Kirill-Zaikin/MY_WORK_REPOSITORY/Robot_forklift/Наклейки/РОБОТЫ НА ОДНОЛ ЛИСТЕ.pdf

РОБОТ 9 МФТИ | РОБОТ 2
РОБОТ 2 МФТИ | РОБОТ 3 МФТИ
РОБОТ 7 МФТИ | РОБОТ 8 МФТИ
