Kirill-Zaikin/MY_WORK_REPOSITORY/Robot_forklift/КД/PDF/чертежи Николки/Перечень чертежей.pdf

ЛТПУ.001.000.000.00

Изм. | Кол.уч | Лист | №док
Подпись | Дата
Разраб. | Герштейн
Програмно-аппаратный комплекс (ПАК)
Стадия | Лист | Листов
1 | 3

ООО «Беспилотный
погрузчик»

Взам. инв. №

Подп. и дата Инв. № подл.

Перечень чертежей

Лист | Наименование | ЦИФР
1 | Габаритный чертеж | ЛТПУ.001.000.000.00 ГЧ
2 | Схема деления | ЛТПУ.001.000.000.00 СД
3 | Принципиальная схема ПАК Э3 | ЛТПУ.001.000.000.00 Э3
4 | Перечень элементов ПАК
5 | Принципиальная схема платы управления Э3 | ЛТПУ.001.001.001.01 Э3
6 | Перечень элементов платы управления
7 | ПАК схема соединения | ЛТПУ.001.000.000.00 СС
8 | ПАК СБ | ЛТПУ.001.000.000.00 СБ
9 | Оптико-электронный комплекс СБ | ЛТПУ.001.001.000.00 СБ
10 | Пояс Безопасности СБ | ЛТПУ.001.002.000.00 СБ
11 | Курсовая камера СБ | ЛТПУ.001.003.000.00 СБ
12 | Концевой выключатель СБ | ЛТПУ.001.004.000.00 СБ
13 | Блок Управления СБ | ЛТПУ.001.001.001.00 СБ
14 | Боковая камера правая СБ | ЛТПУ.001.001.002.00 СБ
15 | Боковая камера левая СБ | ЛТПУ.001.001.003.00 СБ
16 | Защита лидара правая СБ | ЛТПУ.001.002.001.00 СБ
17 | Защита лидара левая СБ | ЛТПУ.001.002.002.00 СБ
18 | Боковая стенка | ЛТПУ.001.001.001.01

ЛТПУ.001.000.000.00

Лист
2
Изм. | Кол.
Лист | №док. | Подп. | Дата

Взам. инв. № Подп. и дата Инв. № подл.

19 | Боковая стенка с отверстиями под кнопки | ЛТПУ.001.001.001.02
20 | Торцевая стенка | ЛТПУ.001.001.001.03
21 | Верхняя стенка | ЛТПУ.001.001.001.04
22 | Нижняя часть коробки для jetson | ЛТПУ.001.001.001.05
23 | Верхняя часть коробки для jetson | ЛТПУ.001.001.001.06
24 | Подложка jetson | ЛТПУ.001.001.001.07
25 | Подложка платы | ЛТПУ.001.001.001.08
26 | Переходная пластина бесперебойника | ЛТПУ.001.001.001.09
27 | Нижняя часть крепления навигационной камеры | ЛТПУ.001.001.001.10
28 | Верхняя часть крепления навигационной камеры | ЛТПУ.001.001.001.11
29 | Держатель разъема | ЛТПУ.001.001.001.12
30 | Боковина крепления камеры | ЛТПУ.001.001.002.01
31 | Боковина крепления камеры 30 градусов | ЛТПУ.001.001.002.02
32 | Пластина камеры под 30 градусов | ЛТПУ.001.001.002.03
33 | Основа крепления камеры | ЛТПУ.001.001.002.04
34 | Переходная пластина камеры правая | ЛТПУ.001.001.002.05
35 | Переходная пластина камеры левая | ЛТПУ.001.001.003.01
36 | Г-образная опора ОЭК | ЛТПУ.001.001.000.01
37 | Задняя опора ОЭК | ЛТПУ.001.001.000.02
38 | Профиль боковой правый | ЛТПУ.001.002.000.01
39 | Профиль боковой левый | ЛТПУ.001.002.000.02
40 | Профиль фронта | ЛТПУ.001.002.000.03
41 | Профиль для пояса безопасности | ЛТПУ.001.002.000.04
42 | Основа лидара нижняя часть | ЛТПУ.001.002.001.01
43 | Основа лидара верхняя часть | ЛТПУ.001.002.001.02

ЛТПУ.001.000.000.00

Лист
3
Изм. | Кол.
Лист | №док. | Подп. | Дата

Взам. инв. № Подп. и дата Инв. № подл.

44 | Боковина лидара | ЛТПУ.001.002.001.03
45 | Крепление курсовой камеры | ЛТПУ.001.003.000.01
46 | Подставка крепления курсовой камеры | ЛТПУ.001.003.000.02
47 | Корпус концевого выключателя | ЛТПУ.001.004.000.01
48 | Толкатель концевого выключателя | ЛТПУ.001.004.000.02
