Kirill-Zaikin/MY_WORK_REPOSITORY/Robot_forklift/КД/PDF/чертежи Николки/temp_A1.png

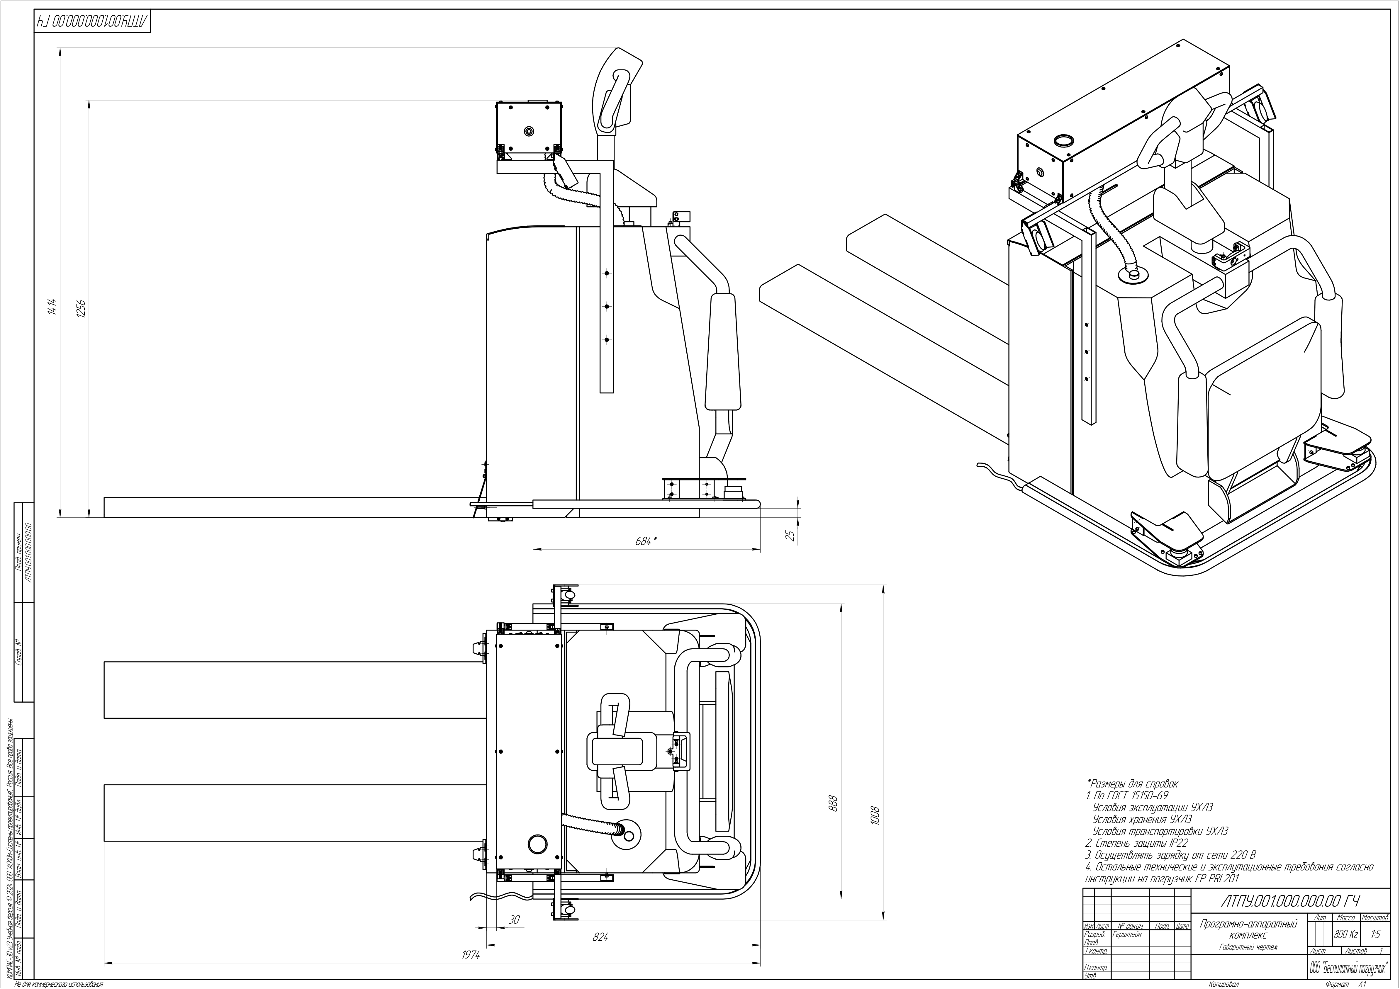
Robot_forklift/КД/PDF/чертежи Николки/temp_A1.png
