Kirill-Zaikin/MY_WORK_REPOSITORY/Robot_forklift/КД/PDF/чертежи Николки/temp_W1686_H2396.png

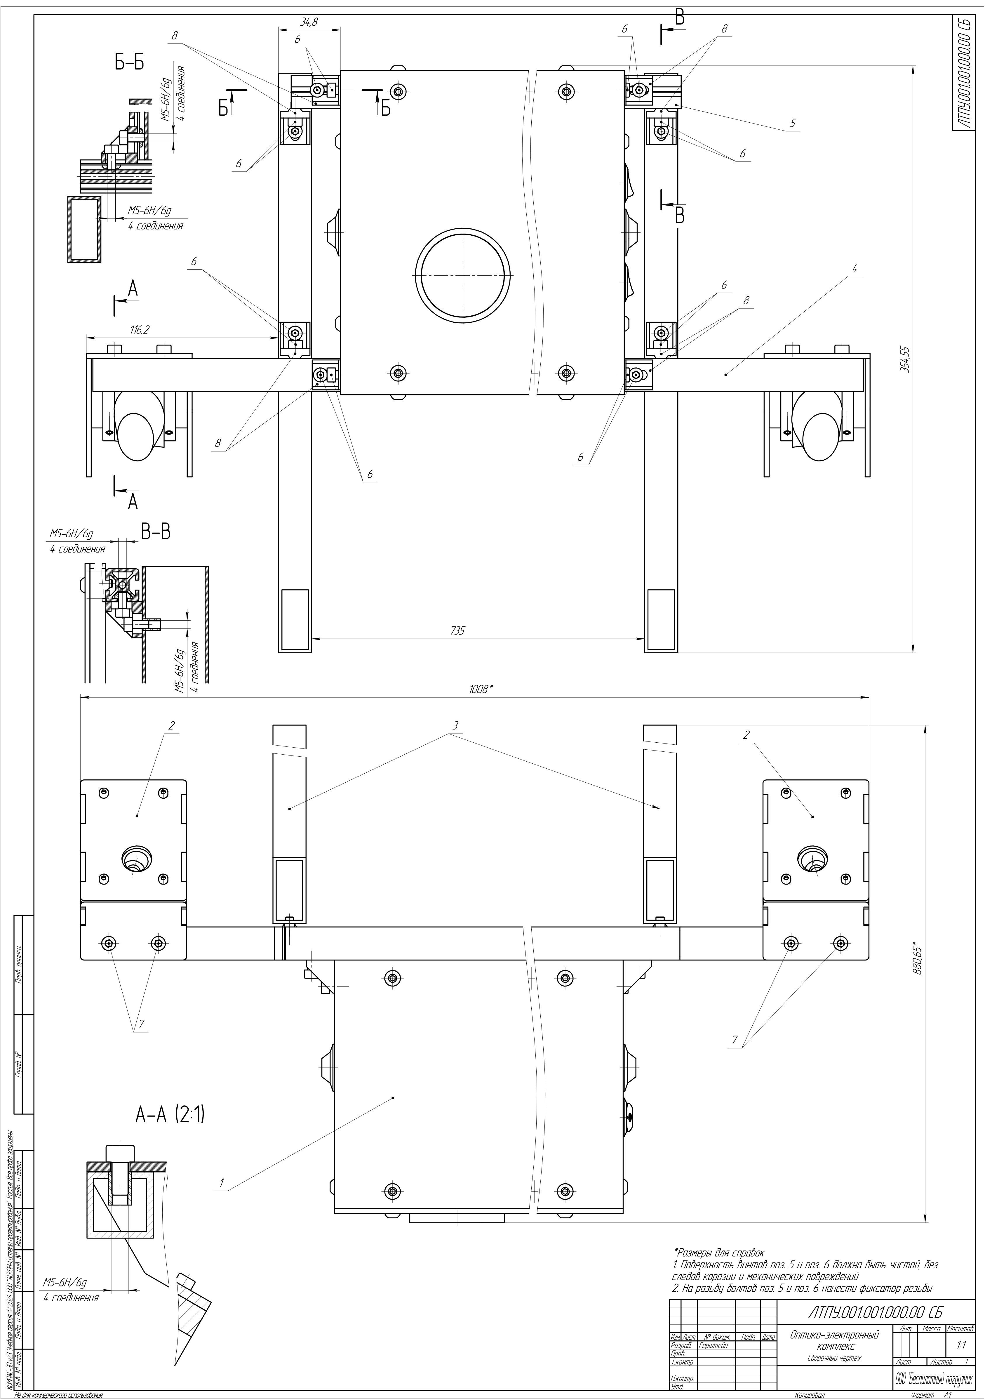
Robot_forklift/КД/PDF/чертежи Николки/temp_W1686_H2396.png
