Kirill-Zaikin/MY_WORK_REPOSITORY/Robot_forklift/КД/Печатные платы/Ублюдок/ChineGerber/Main_STM_box-F_Cu.dxf

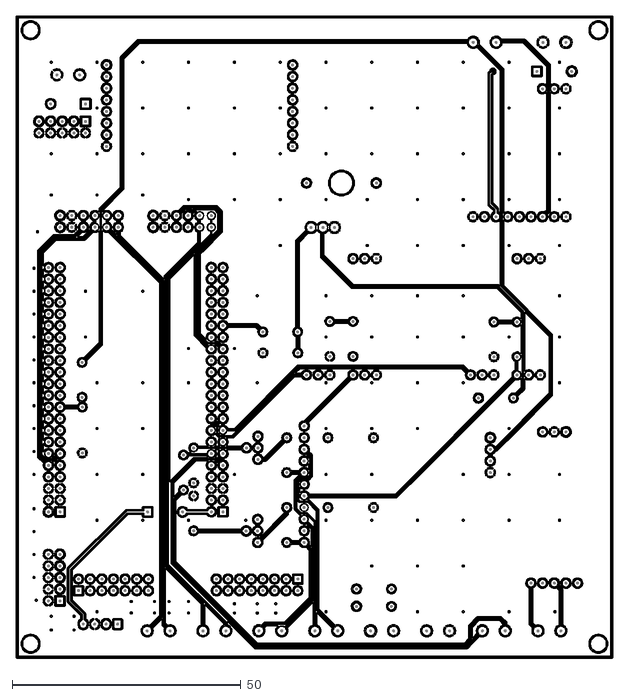
[picture p15: CAD file, 2025-08-18]
Robot_forklift/КД/Печатные платы/Ублюдок/ChineGerber/Main_STM_box-F_Cu.dxf
130.2 x 140.2
