Kirill-Zaikin/MY_WORK_REPOSITORY/Robot_forklift/модели/Колику/разъем_2022.SLDASM

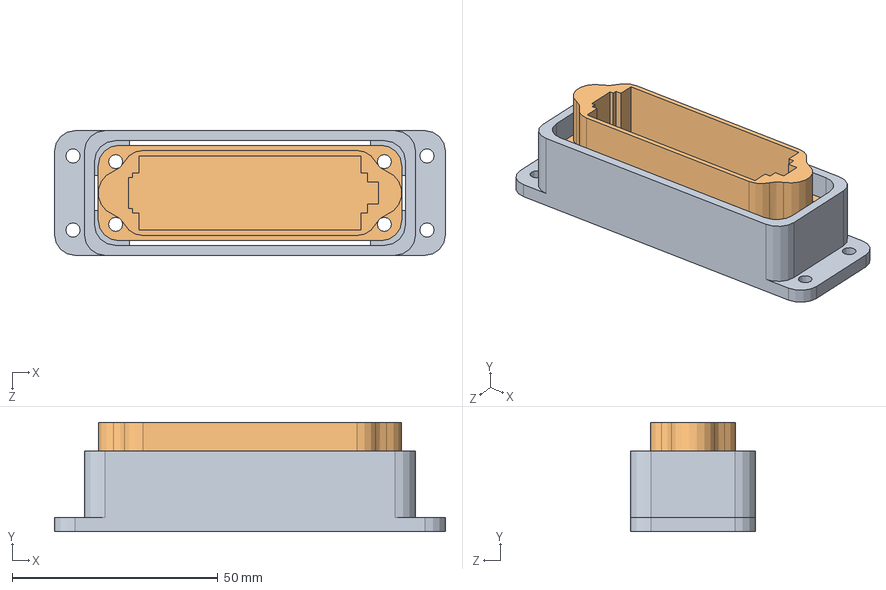
[picture p16: CAD file, 2025-08-18]
Robot_forklift/модели/Колику/разъем_2022.SLDASM
95.0 x 26.6 x 30.3 mm
разъем 20 контактов_рубашка
Вилка 20 контактов
