Kirill-Zaikin/MY_WORK_REPOSITORY/Robot_forklift/модели/Петля/Петля.SLDASM

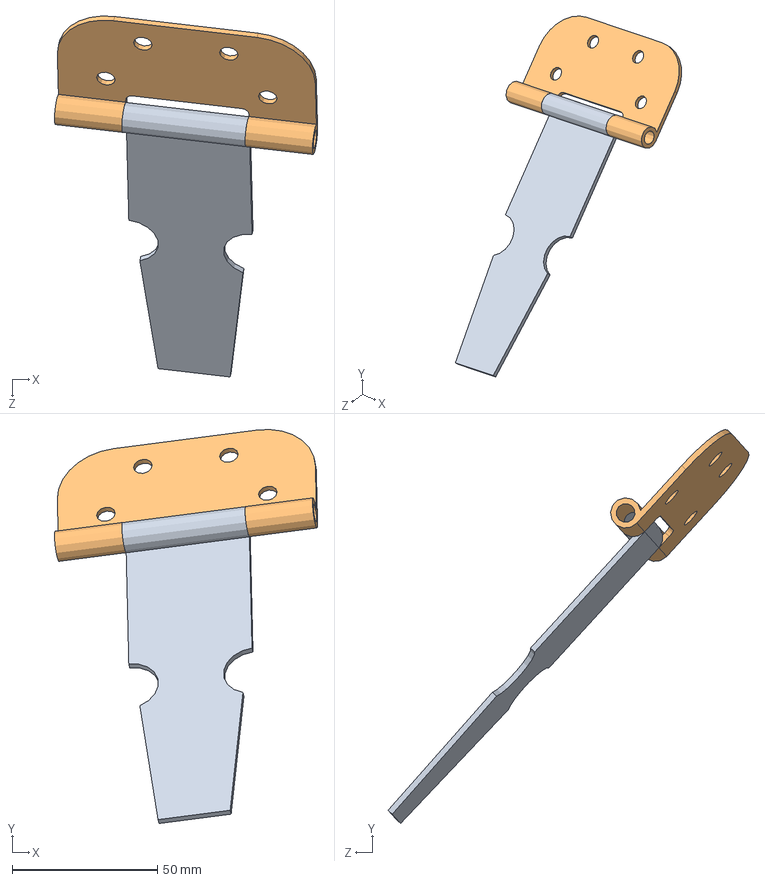
[picture p17: CAD file, 2025-08-18]
Robot_forklift/модели/Петля/Петля.SLDASM
90.4 x 135.4 x 124.1 mm
Тело петли
Язычок петли
