Kirill-Zaikin/MY_WORK_REPOSITORY/Robot_forklift/модели/Колику/Петля_2022.SLDASM

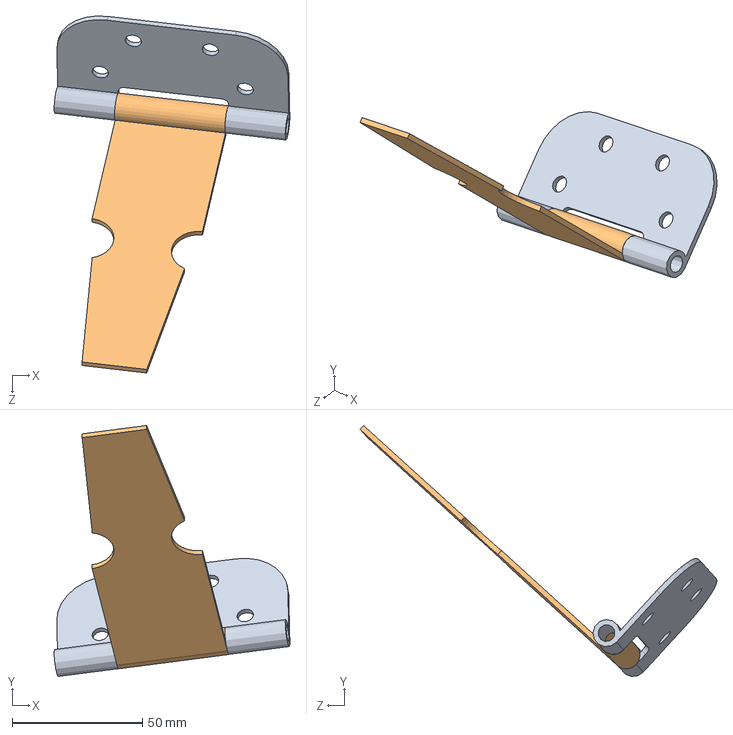
[picture p20: CAD file, 2025-08-18]
Robot_forklift/модели/Колику/Петля_2022.SLDASM
90.4 x 96.3 x 137.0 mm
Тело петли
Язычок петли
