Kirill-Zaikin/MY_WORK_REPOSITORY/Robot_forklift/модели/Оптический фильтр.SLDPRT

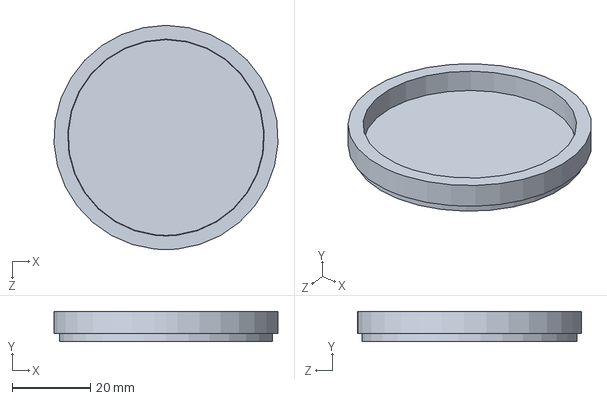
[picture p21: CAD file, 2025-08-18]
Robot_forklift/модели/Оптический фильтр.SLDPRT
57.2 x 7.69 x 57.3 mm
