Kirill-Zaikin/MY_WORK_REPOSITORY/Robot_forklift/модели/разъем/разъем 20 контактов_рубашка.SLDPRT

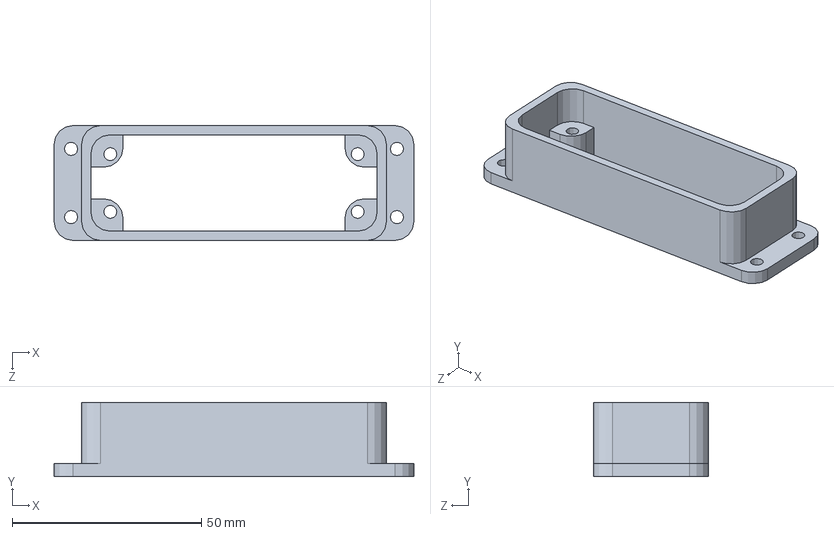
[picture p22: CAD file, 2025-08-18]
Robot_forklift/модели/разъем/разъем 20 контактов_рубашка.SLDPRT
95.0 x 19.5 x 30.3 mm
