Kirill-Zaikin/MY_WORK_REPOSITORY/Robot_forklift/Оснастка/Винт для лампы.SLDPRT

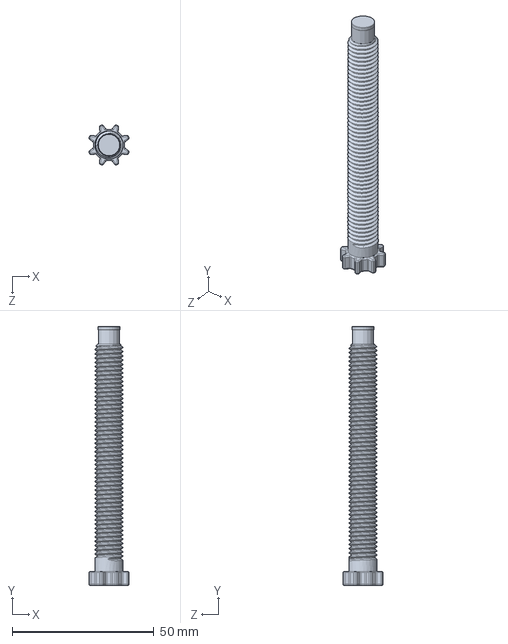
[picture p23: CAD file, 2025-03-12]
Robot_forklift/Оснастка/Винт для лампы.SLDPRT
14.1 x 91.2 x 14.1 mm
