Kirill-Zaikin/MY_WORK_REPOSITORY/Robot_forklift/модели/Выключатель клавишный круглый.SLDPRT

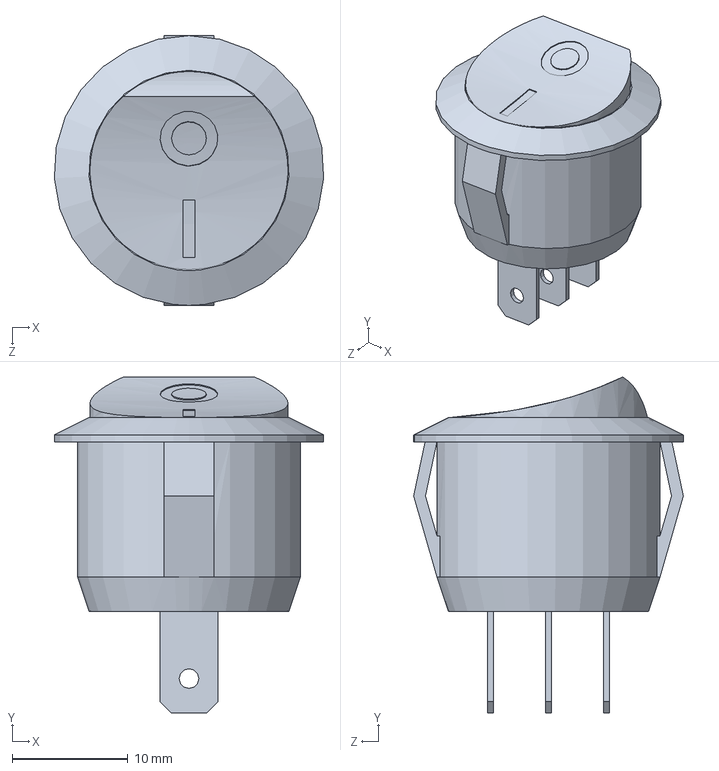
[picture p24: CAD file, 2025-08-18]
Robot_forklift/модели/Выключатель клавишный круглый.SLDPRT
23.3 x 29.0 x 23.3 mm
