Kirill-Zaikin/MY_WORK_REPOSITORY/Robot_forklift/модели/Колику/Тело петли_2022.SLDPRT

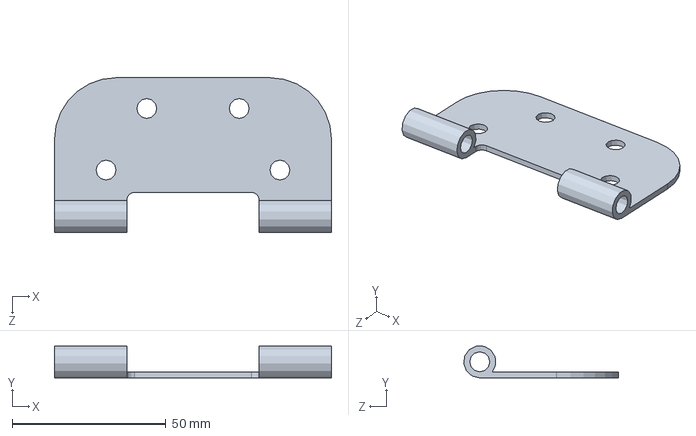
[picture p25: CAD file, 2025-08-18]
Robot_forklift/модели/Колику/Тело петли_2022.SLDPRT
90.0 x 10.4 x 50.2 mm
