Kirill-Zaikin/MY_WORK_REPOSITORY/Robot_forklift/модели/разъем/Вилка 20 контактов.SLDPRT

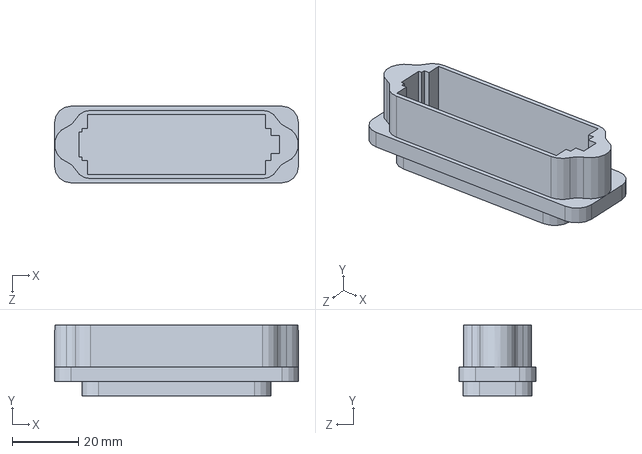
[picture p26: CAD file, 2025-08-18]
Robot_forklift/модели/разъем/Вилка 20 контактов.SLDPRT
73.8 x 21.4 x 23.2 mm
