Kirill-Zaikin/MY_WORK_REPOSITORY/Robot_forklift/Оснастка/Держало лампы.STEP

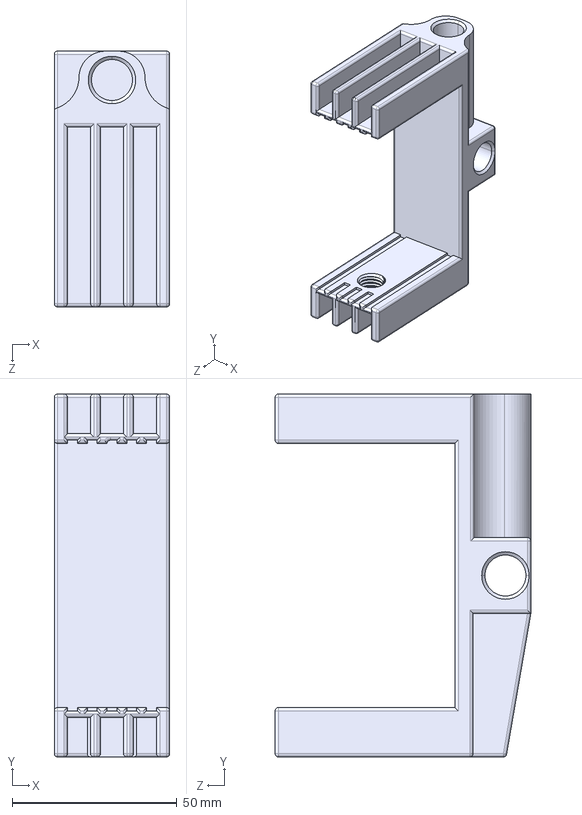
[picture p27: CAD file, 2025-03-12]
Robot_forklift/Оснастка/Держало лампы.STEP
35.0 x 110.0 x 77.5 mm
