Kirill-Zaikin/MY_WORK_REPOSITORY/Robot_forklift/модели/Кнопка пояса.SLDPRT

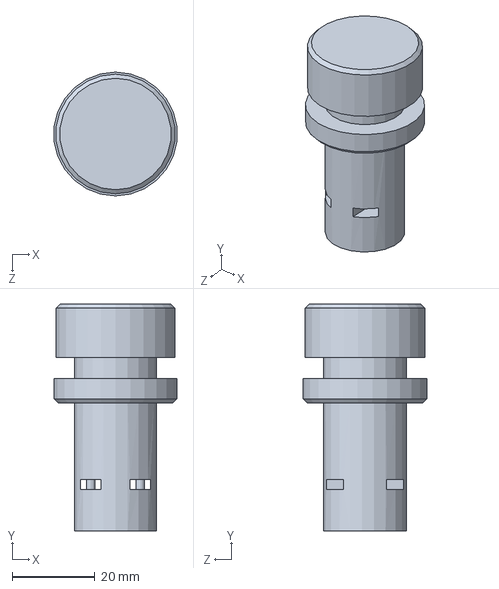
[picture p28: CAD file, 2025-08-18]
Robot_forklift/модели/Кнопка пояса.SLDPRT
29.8 x 55.0 x 30.0 mm
