Kirill-Zaikin/MY_WORK_REPOSITORY/Robot_forklift/модели/Колику/гофра_2022.SLDPRT

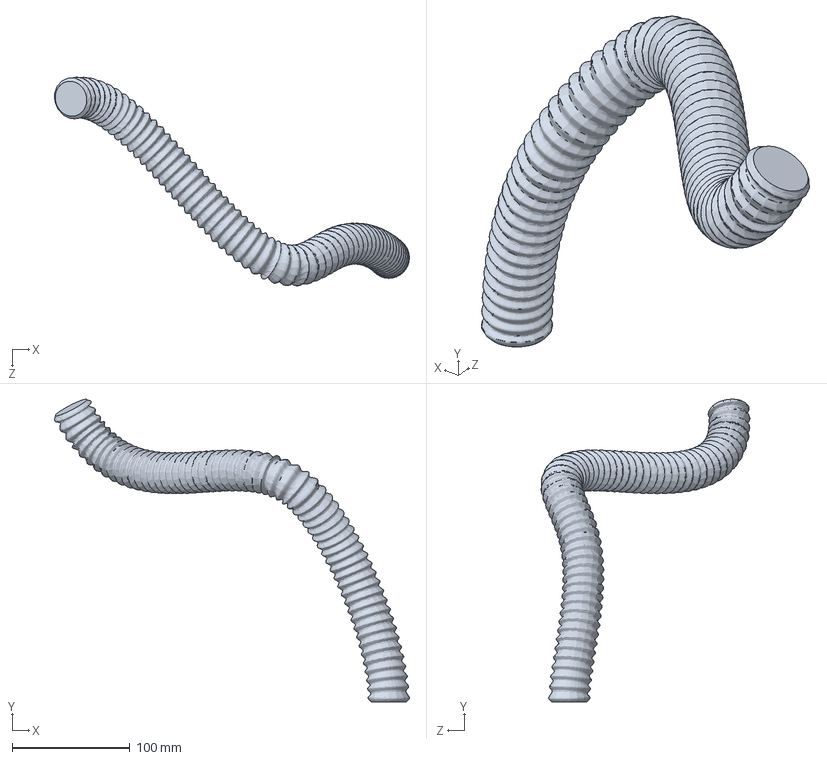
[picture p29: CAD file, 2025-08-18]
Robot_forklift/модели/Колику/гофра_2022.SLDPRT
301.6 x 257.2 x 177.3 mm
