Kirill-Zaikin/MY_WORK_REPOSITORY/Robot_forklift/модели/Петля/Язычок петли.SLDPRT

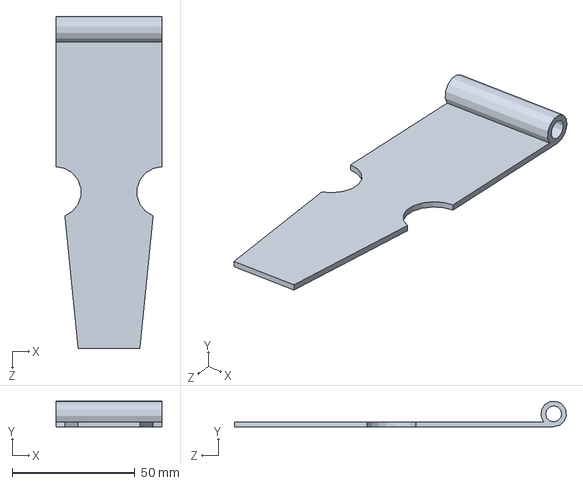
[picture p30: CAD file, 2025-08-18]
Robot_forklift/модели/Петля/Язычок петли.SLDPRT
43.0 x 10.4 x 135.2 mm
