Kirill-Zaikin/MY_WORK_REPOSITORY/Robot_forklift/модели/Поворотник.SLDPRT

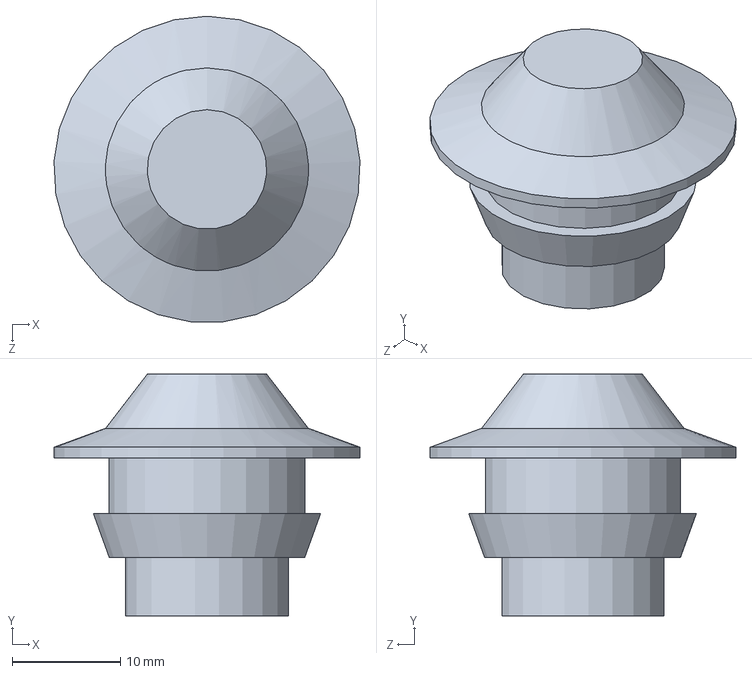
[picture p31: CAD file, 2025-08-18]
Robot_forklift/модели/Поворотник.SLDPRT
28.3 x 22.3 x 28.2 mm
