Kirill-Zaikin/MY_WORK_REPOSITORY/(list of files, cad)

Other CAD files:
Robot_forklift/модели/разъем/разъем.SLDASM
Robot_forklift/модели/Петля/Тело петли.SLDPRT
Robot_forklift/модели/Колику/Кнопка пояса_2022.SLDPRT
Robot_forklift/модели/гофра.SLDPRT
Robot_forklift/модели/Колику/Выключатель клавишный круглый_2022.SLDPRT
Robot_forklift/модели/Колику/рубашка_2022.SLDPRT
Robot_forklift/модели/Колику/Язычок петли_2022.SLDPRT
Robot_forklift/модели/Колику/Поворотник_2022.SLDPRT
Robot_forklift/модели/Колику/Вилка_2022.SLDPRT
Robot_forklift/модели/Колику/Оптический фильтр_2022.SLDPRT
