Kirill-Zaikin/MY_WORK_REPOSITORY/Robot_forklift/КД/PDF/ПАК перечень.pdf

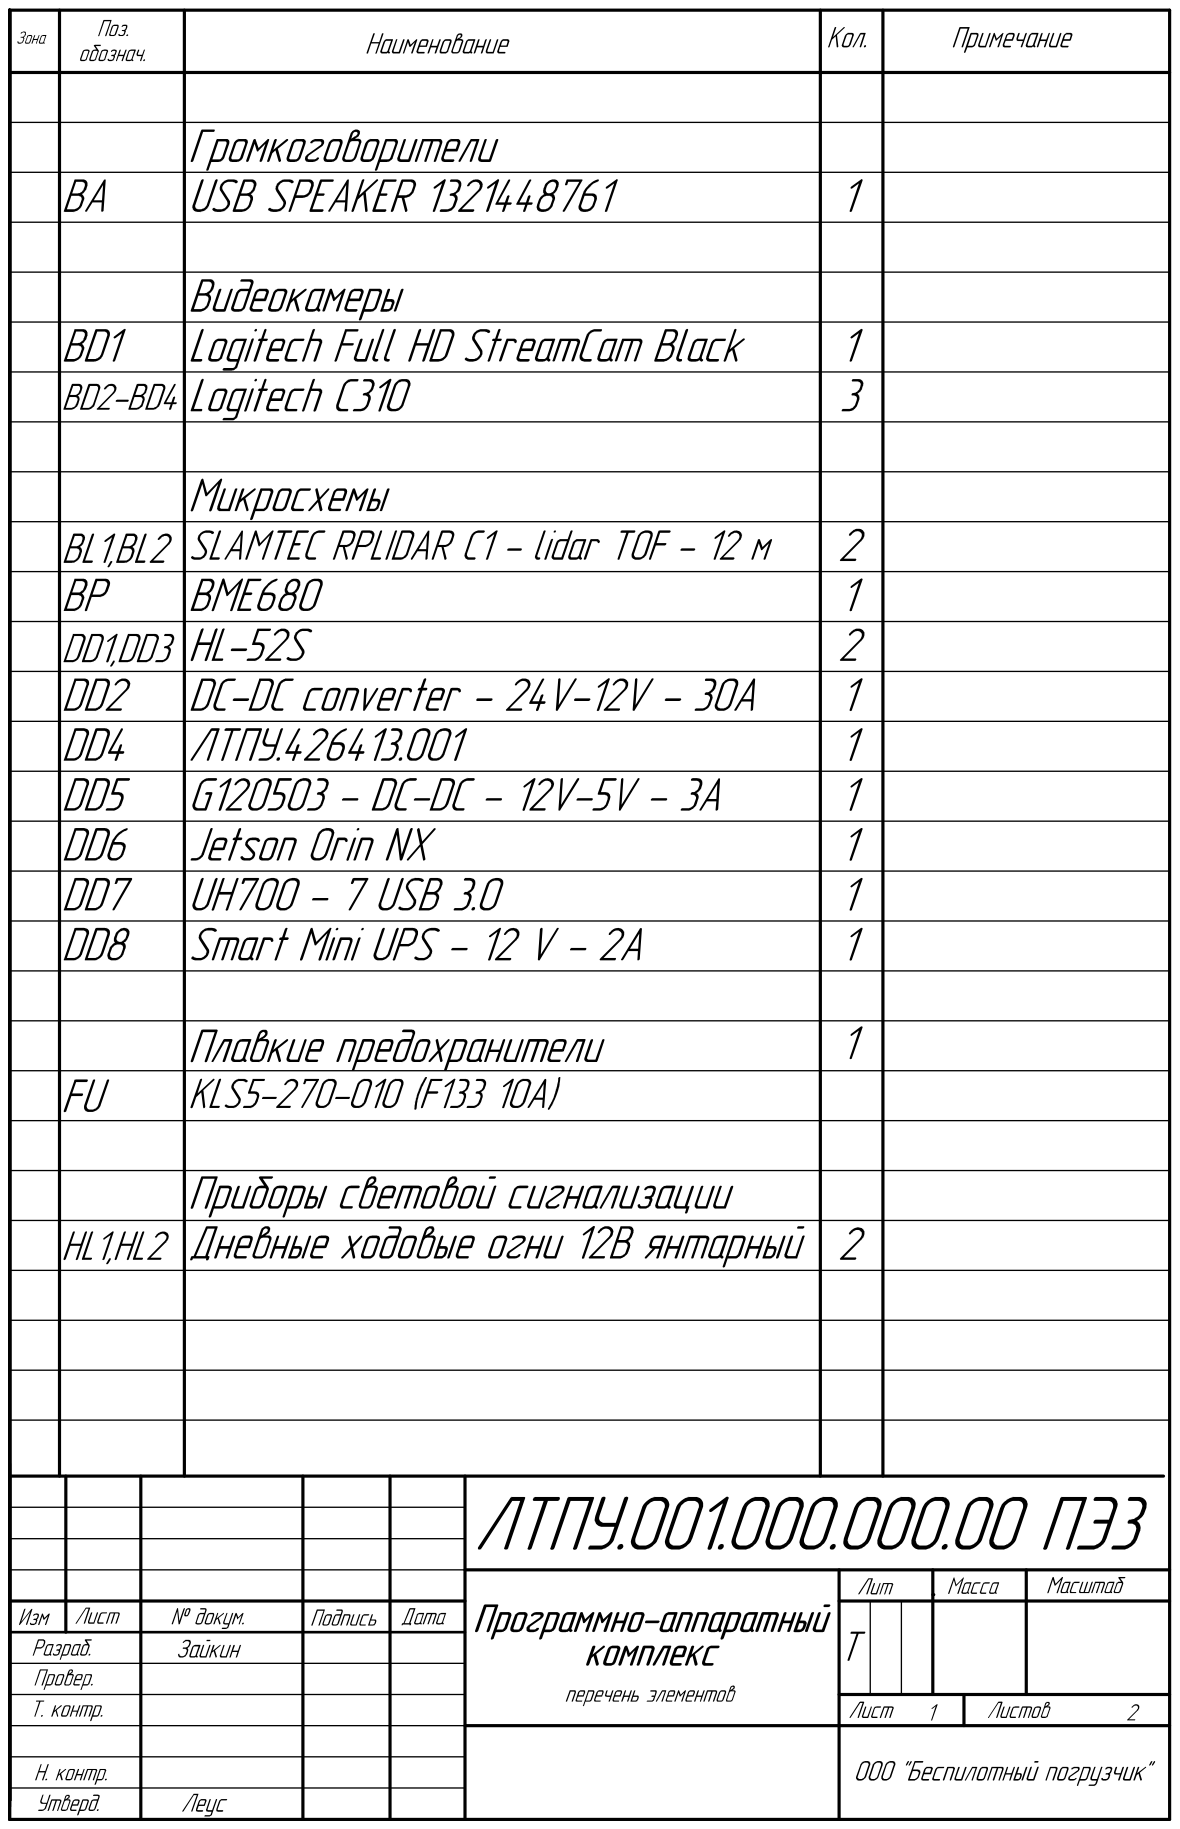
[picture p32: page 1]

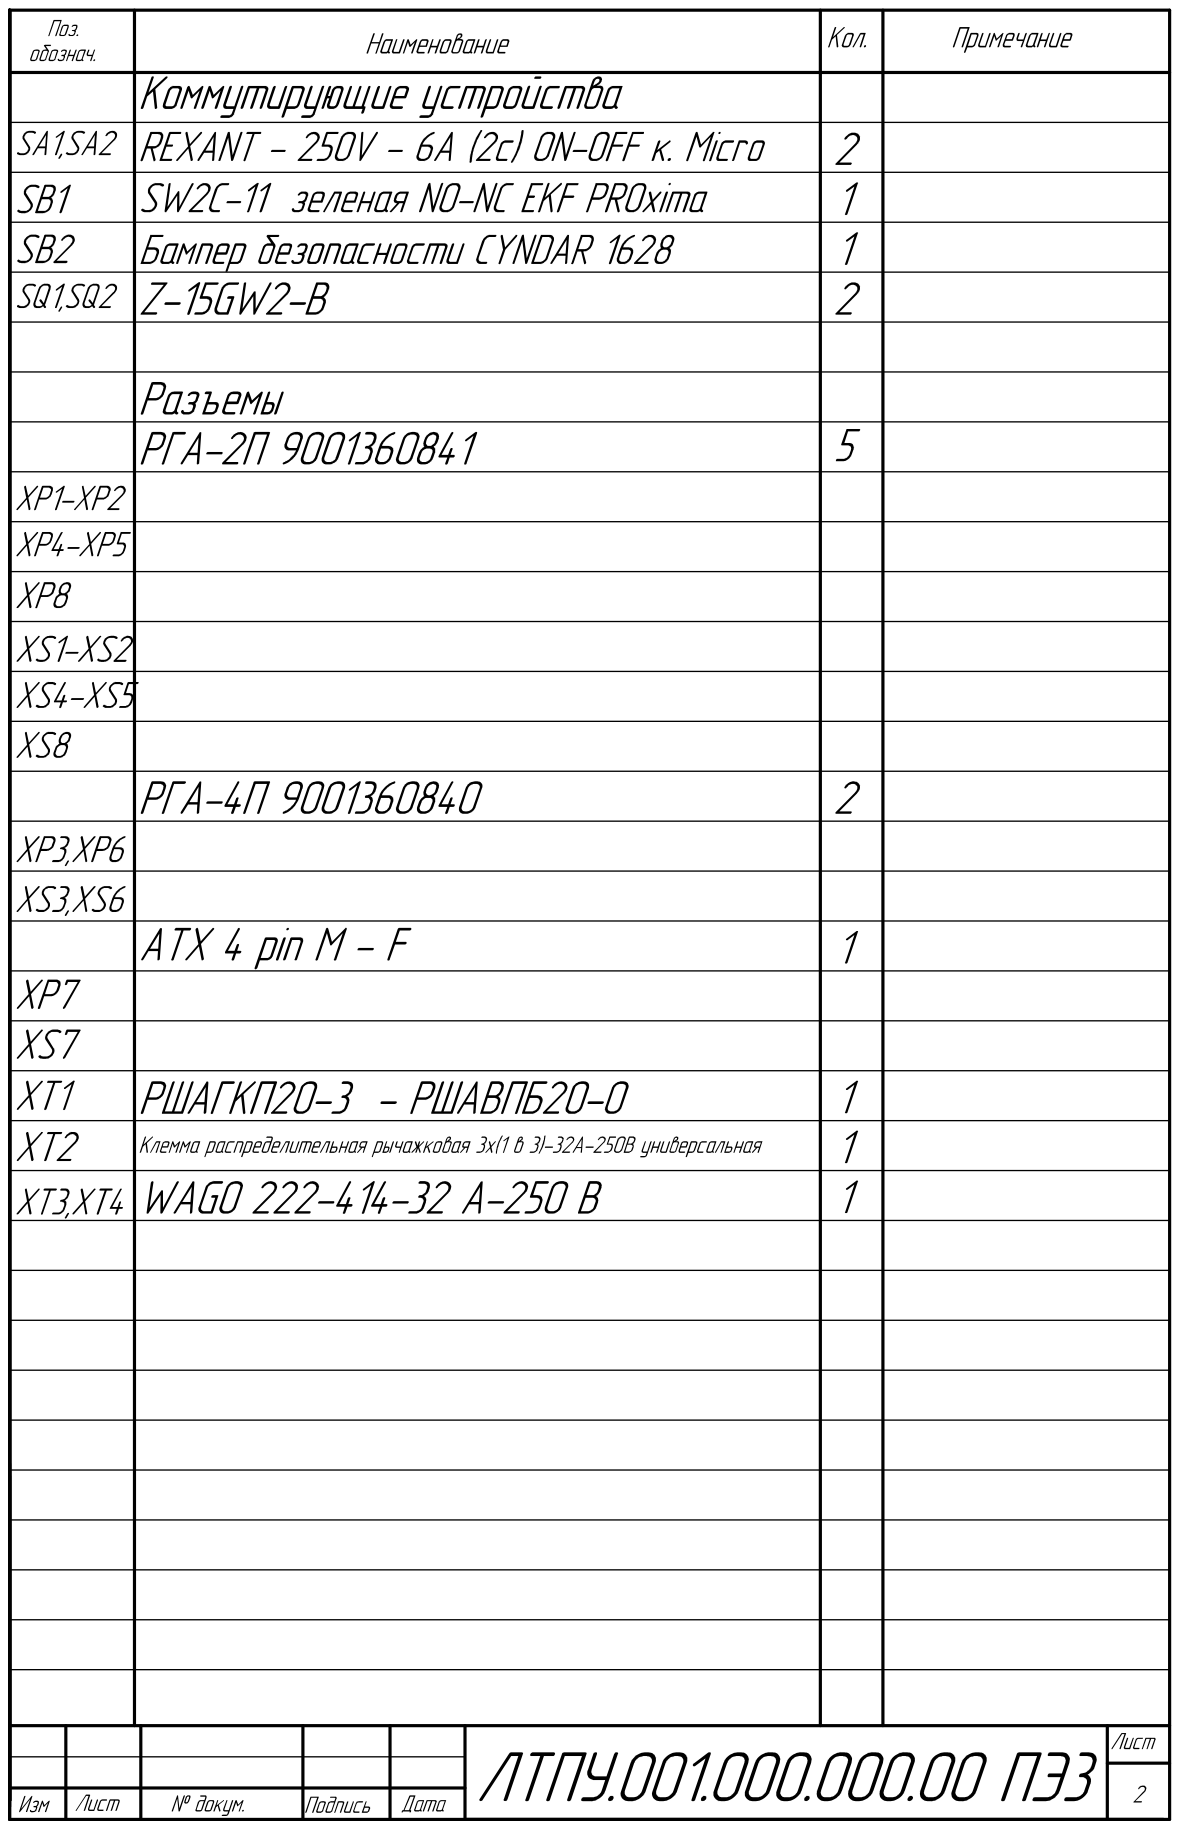
[picture p33: page 2]
