Kirill-Zaikin/MY_WORK_REPOSITORY/Robot_forklift/КД/PDF/Плата управления перечень.pdf

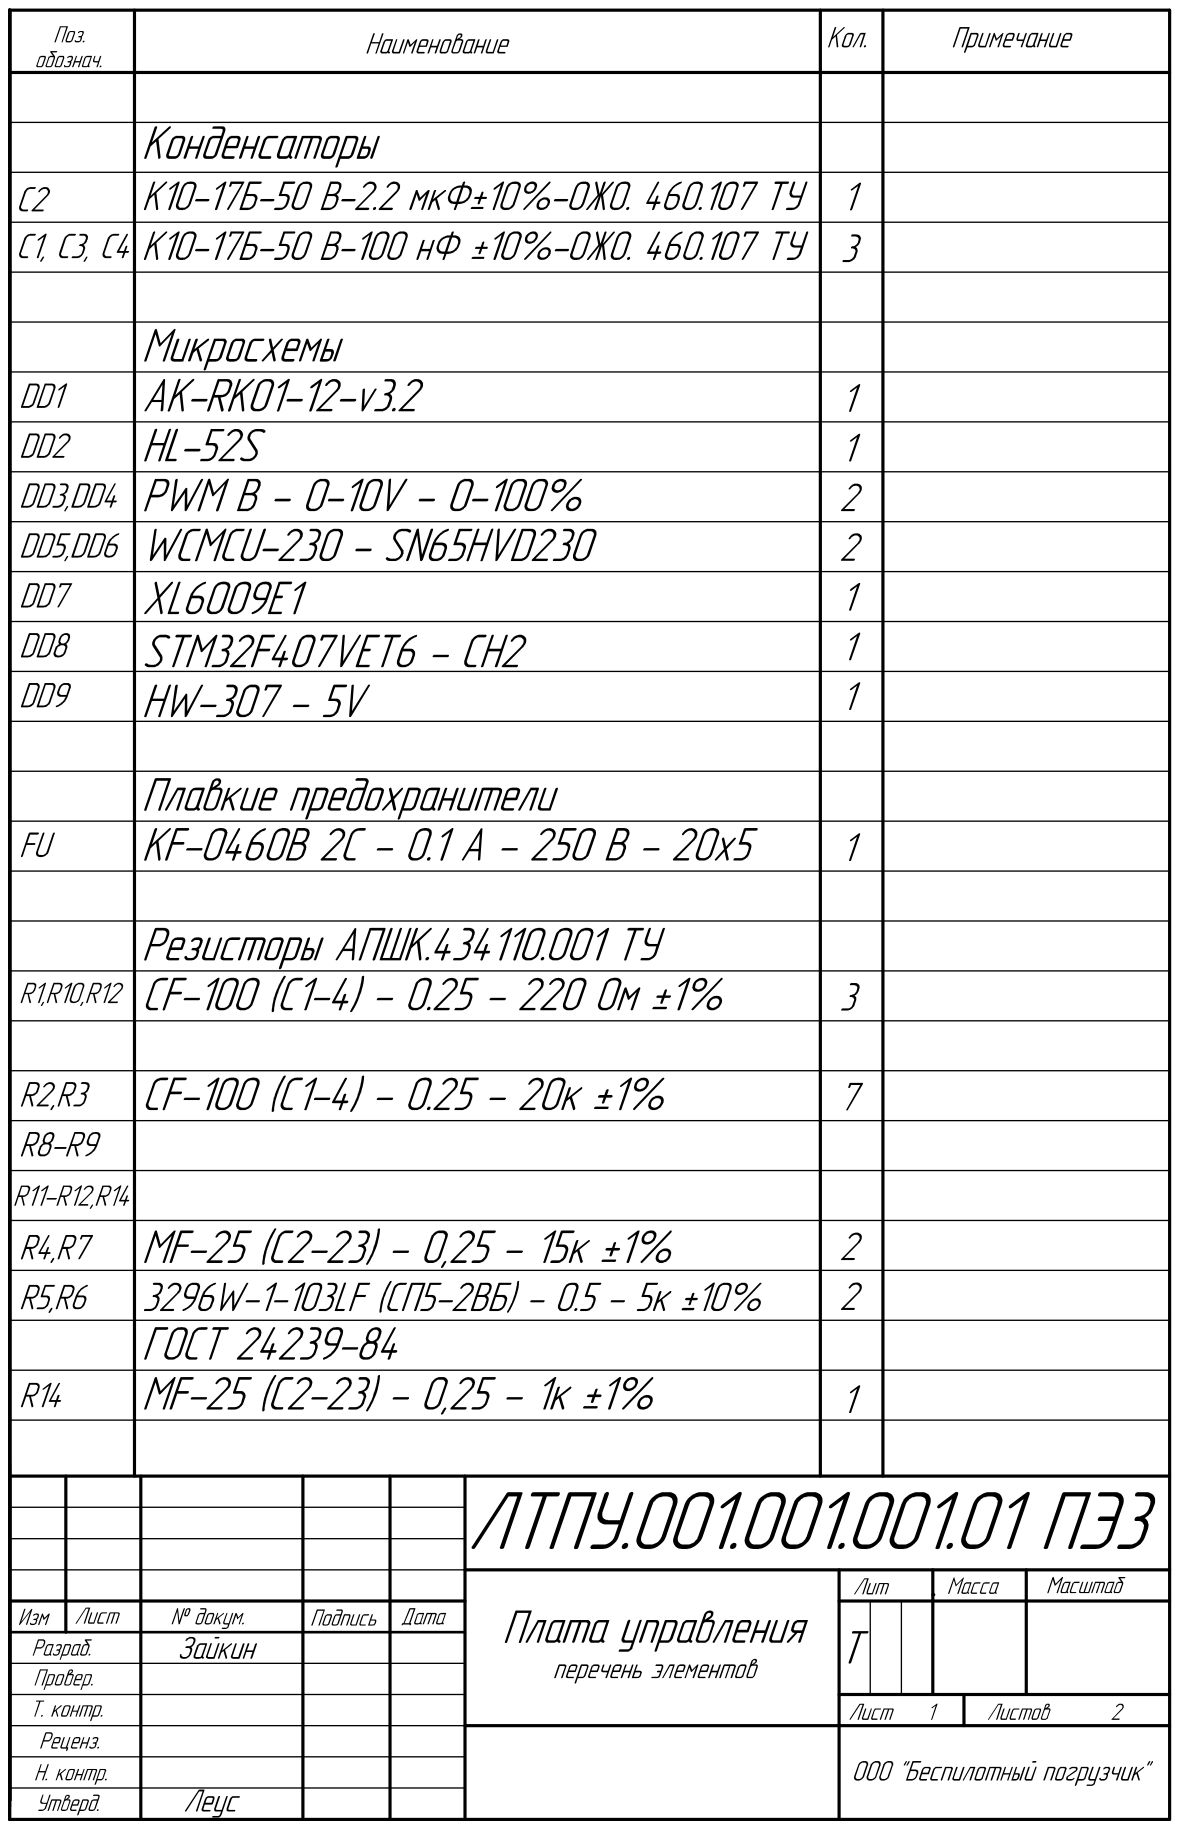
[picture p34: page 1]

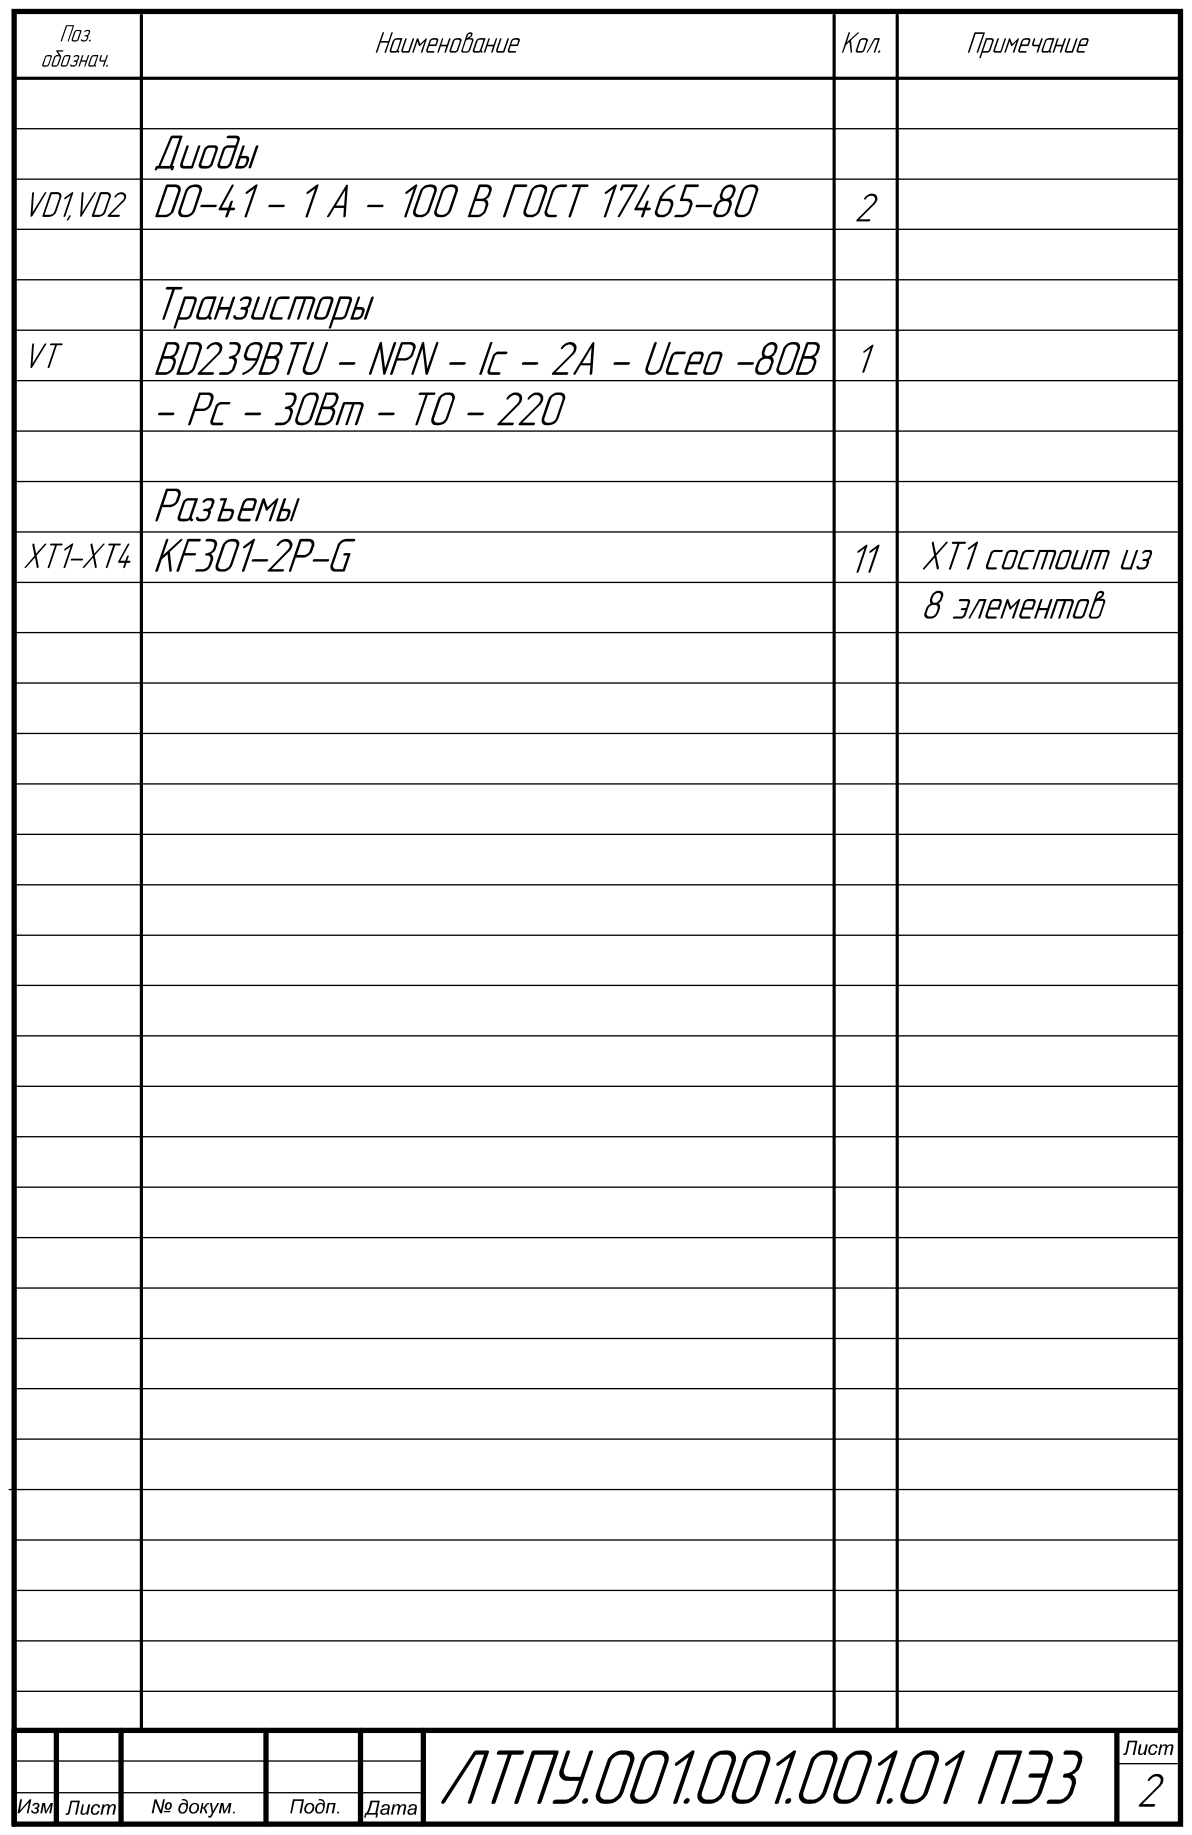
[picture p35: page 2]
