Kirill-Zaikin/MY_WORK_REPOSITORY/(list of files, drawings)

Other design files:
Robot_forklift/КД/Backup_of_Backup_of_Беспилотный погрузчик.spl8
Robot_forklift/КД/Backup_of_Беспилотный_погрузчик_схема_соединений.spl8
Robot_forklift/КД/Backup_of_ПАК.spl8
Robot_forklift/КД/Backup_of_Плата для космонавтов.spl8
Robot_forklift/КД/Backup_of_Плата управления.spl8
Robot_forklift/КД/Backup_of_ТИТУЛЬНИК НА КД.spl8
Robot_forklift/КД/Беспилотный_погрузчик_схема_соединений.spl8
Robot_forklift/КД/Испытатаельный стенд.spl8
Robot_forklift/КД/ПАК.spl8
Robot_forklift/КД/Плата управления.spl8
Robot_forklift/КД/ТИТУЛЬНИК НА КД.spl8
