Kirill-Zaikin/MY_WORK_REPOSITORY/Robot_forklift/КД/Печатные платы/Ублюдок/Main_STM_box.kicad_pcb

## KiCad design Robot_forklift/КД/Печатные платы/Ублюдок/Main_STM_box.kicad_pcb (2025-08-18)

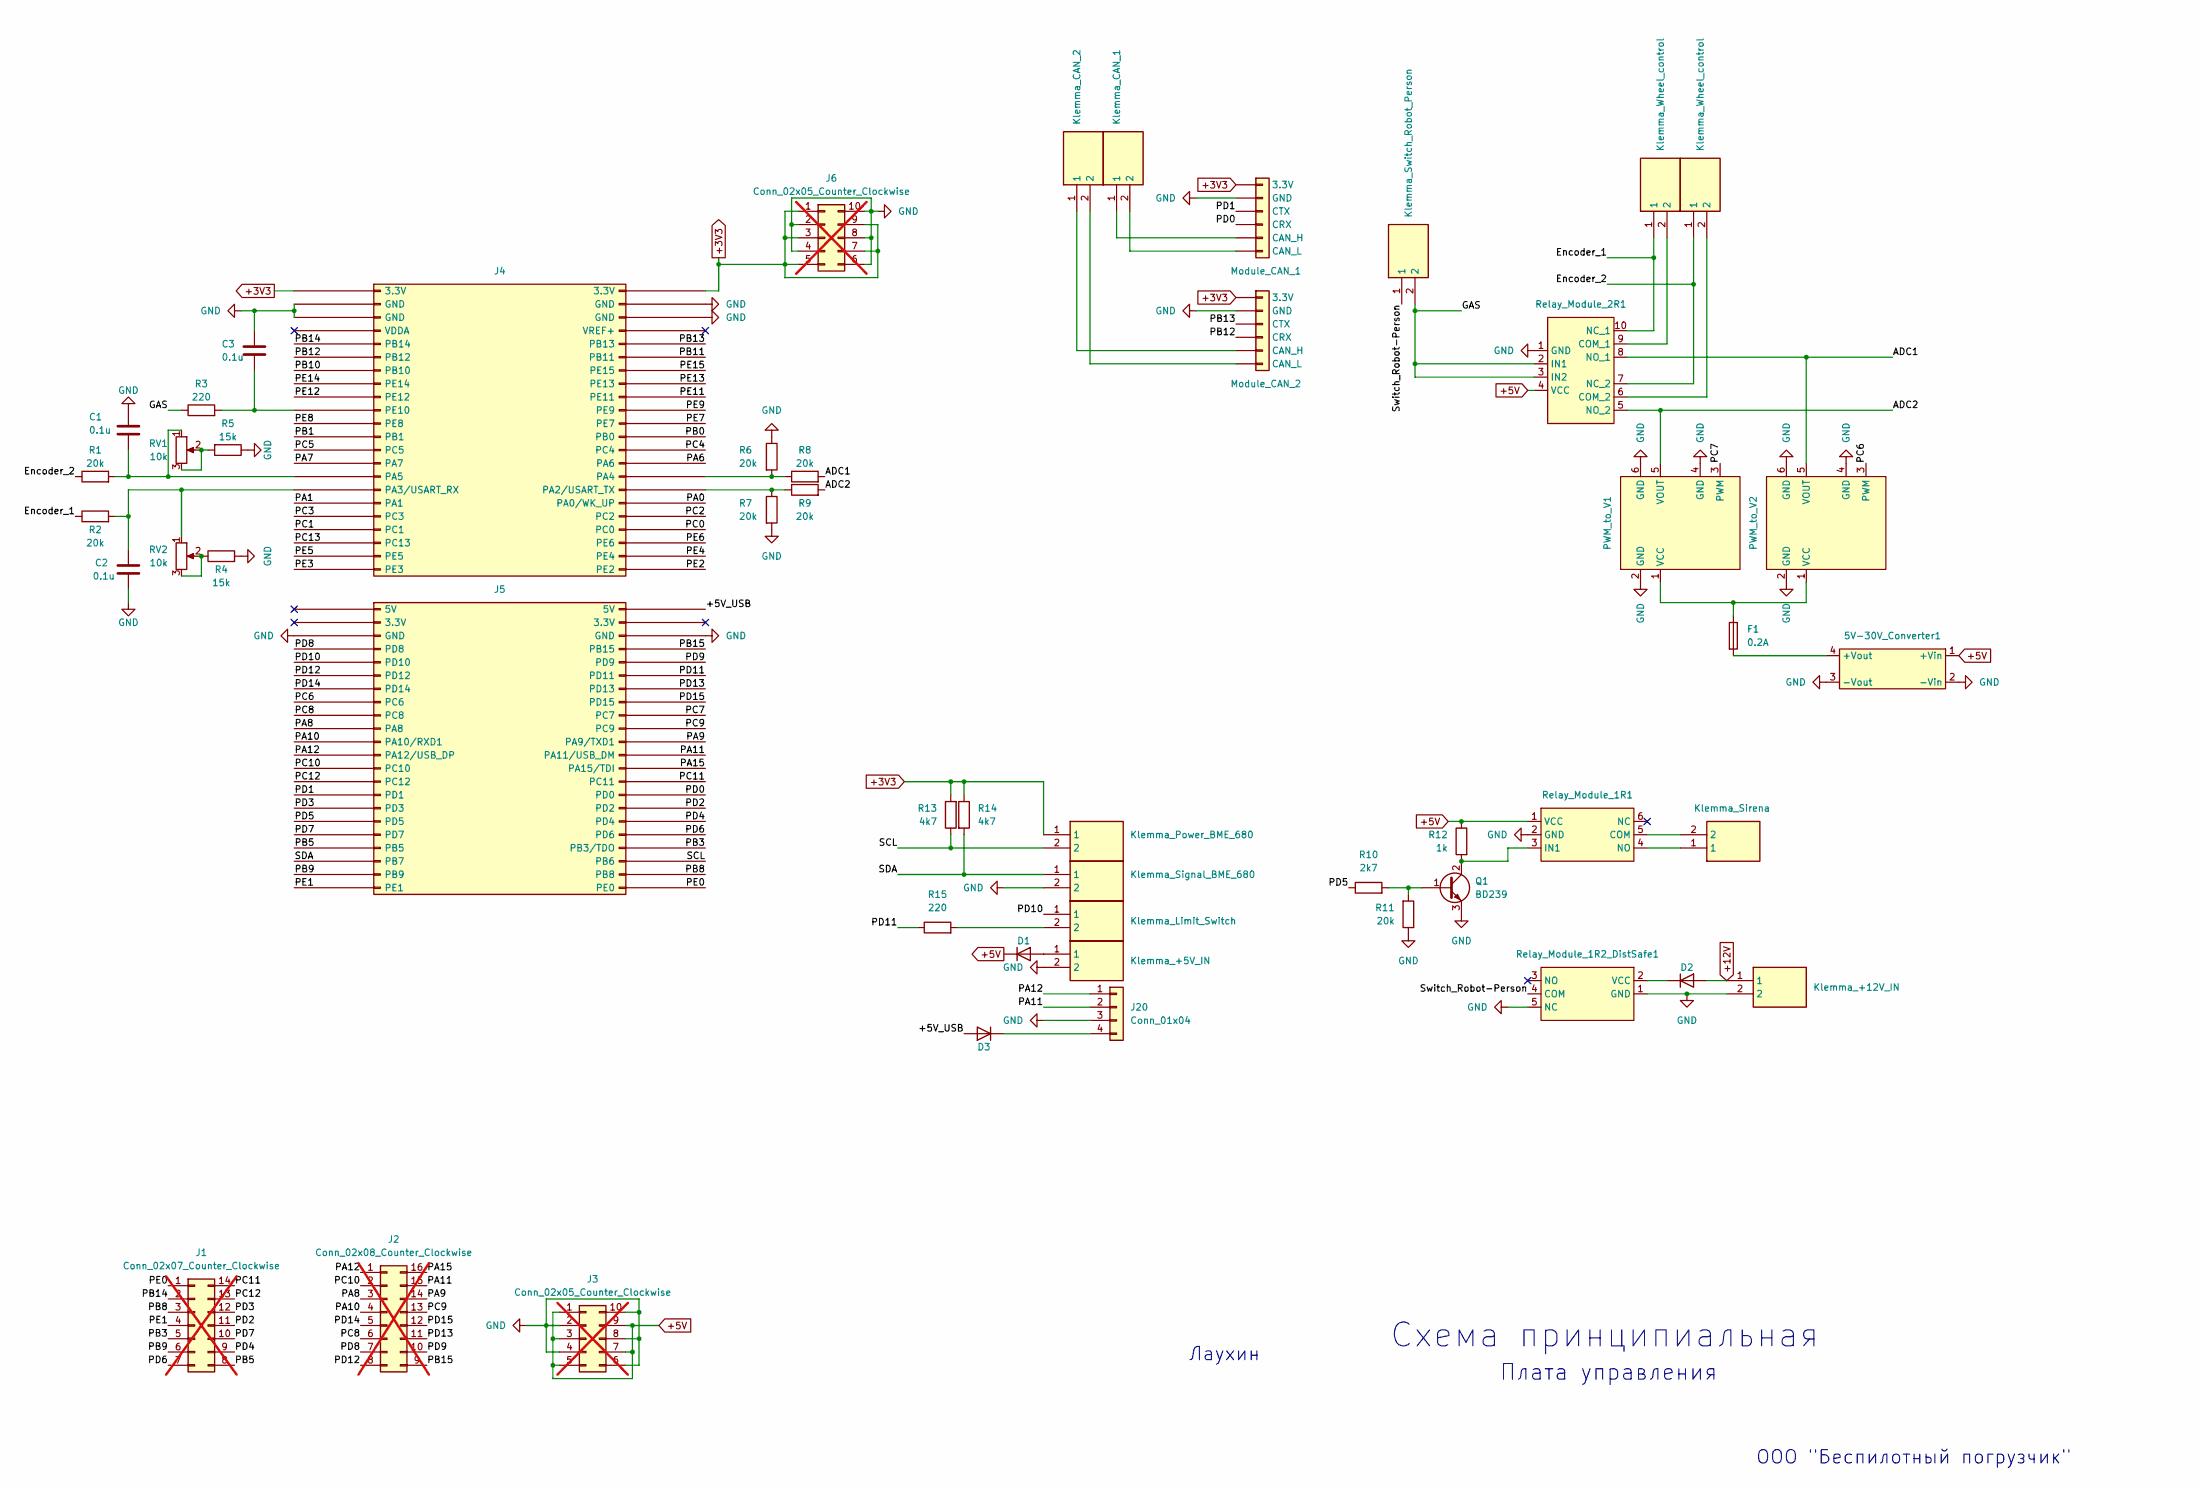
[picture p36: schematic Main_STM_box.kicad_sch]

Parts:
5V-30V_Converter1: 5V-30V_Converter; Manufacturer_Part_Number PBS-8 (DS-1023 -1x 8)
C1, C2, C3: 0.1u; C_Axial_L3.8mm_D2.6mm_P10.00mm_Horizontal; Manufacturer_Part_Number К10-17Б 0.1 мкФ X7R,10%, 1206, JYM1H104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
D1, D2, D3: D; D_A-405_P7.62mm_Horizontal; Manufacturer_Part_Number 1N4002
F1: 0.2A; FuseHolder_5x20mm; Manufacturer_Part_Number 2672 пред держ 5x20\закр\2P\\\
J1: Conn_02x07_Counter_Clockwise; PinHeader_2x07_P2.54mm_Vertical; not fitted
J2: Conn_02x08_Counter_Clockwise; PinHeader_2x08_P2.54mm_Vertical; not fitted
J3, J6: Conn_02x05_Counter_Clockwise; PinHeader_2x05_P2.54mm_Vertical; not fitted
J4, J5: Conn_02x22_Odd_Even; PinSocket_2x22_P2.54mm_Vertical; Manufacturer_Part_Number PBD-44 (DS1023-2x22S21)
J7: Klemma_Power_BME_680; KF3012P; Manufacturer_Part_Number KF301-2P
J8: Klemma_Signal_BME_680; KF3012P; Manufacturer_Part_Number KF301-2P
J9: Klemma_Limit_Switch; KF3012P; Manufacturer_Part_Number KF301-2P
J10: Klemma_+5V_IN; KF3012P; Manufacturer_Part_Number KF301-2P
J11: Klemma_CAN_2; KF3012P; Manufacturer_Part_Number KF301-2P
J12: Klemma_CAN_1; KF3012P; Manufacturer_Part_Number KF301-2P
J13: Module_CAN_1; WCMCU-230; Manufacturer_Part_Number PBD-12 (DS-1023 - 2x6)
J14: Module_CAN_2; WCMCU-230; Manufacturer_Part_Number PBD-12 (DS-1023 - 2x6)
J15: Klemma_Switch_Robot_Person; KF3012P; Manufacturer_Part_Number KF301-2P
J16, J18: Klemma_Wheel_control; KF3012P; Manufacturer_Part_Number KF301-2P
J17: Klemma_Sirena; KF3012P; Manufacturer_Part_Number KF301-2P
J19: Klemma_+12V_IN; KF3012P; Manufacturer_Part_Number KF301-2P
J20: Conn_01x04; JST_XH_B4B-XH-A_1x04_P2.50mm_Vertical
PWM_to_V1, PWM_to_V2: PWMtoV; Manufacturer_Part_Number PBS-3 (DS-1023 - 1x3)
Q1: BD239; Q_Transistor_footprint_NPN_PNP; Manufacturer_Part_Number BD239BTU
R1, R2, R6, R7, R8, R9, R11: 20k; R_Axial_DIN0207_L6.3mm_D2.5mm_P7.62mm_Horizontal; Manufacturer_Part_Number MF-25 (С2-23) 0.25 Вт, 20 кОм, 1%
R3: 220; R_Axial_DIN0207_L6.3mm_D2.5mm_P7.62mm_Horizontal; Manufacturer_Part_Number MF-25 (С2-23) 0.25 Вт, 220 Ом, 1%
R4, R5: 15k; R_Axial_DIN0207_L6.3mm_D2.5mm_P7.62mm_Horizontal; Manufacturer_Part_Number MF-25 (С2-23) 0.25 Вт, 15 кОм, 1%
R10: 2k7; R_Axial_DIN0207_L6.3mm_D2.5mm_P7.62mm_Horizontal; Manufacturer_Part_Number MF-25 (С2-23) 0.25 Вт, 2.7 кОм, 1%
R12: 1k; R_Axial_DIN0207_L6.3mm_D2.5mm_P7.62mm_Horizontal; Manufacturer_Part_Number MF-25 (С2-23) 0.25 Вт, 1 кОм, 1%
R13, R14: 4k7; R_Axial_DIN0207_L6.3mm_D2.5mm_P7.62mm_Horizontal; Manufacturer_Part_Number MF-25 (С2-23) 0.25 Вт, 4.7 кОм, 1%
R15: 220; R_Axial_DIN0207_L6.3mm_D2.5mm_P7.62mm_Horizontal
RV1, RV2: 10k; VSE_Potentiometers_W103_3296; Manufacturer_Part_Number 3296W-1-103LF (СП5-2ВБ), 10 кОм
Relay_Module_1R1: Relay_Module_1R; Manufacturer_Part_Number PBS-5 (DS-1023 - 1x5) + PBS-3 (DS-1023 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
Relay_Module_1R2_DistSafe1: Distance_Relay_Module; Manufacturer_Part_Number PBS-3 (DS-1023 - 1x3) + PBS-9 (DS1023-1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
Relay_Module_2R1: Relay_Module_2R; Manufacturer_Part_Number PBS-4 (DS-1023 - 1x4) + PBS-11 (DS1023-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

Connections:
+3V3: J4.1 (3.3V), J4.2 (3.3V), J6.1, J6.3, J6.5, J6.7, J6.9, J7.1, J13.1 (3.3V), J14.1 (3.3V), R13.2, R14.1
+5V: 5V-30V_Converter1.1 (+Vin), D1.1 (K), J3.1, J3.3, J3.5, J3.7, J3.9, R12.1, Relay_Module_1R1.1 (VCC), Relay_Module_2R1.4 (VCC)
+12V: D2.2 (A), J19.1
/+5V_USB: D3.2 (A), J5.2 (5V)
/ADC1: PWM_to_V2.5 (VOUT), R8.2, Relay_Module_2R1.8 (NO_1)
/ADC2: PWM_to_V1.5 (VOUT), R9.2, Relay_Module_2R1.5 (NO_2)
/Encoder_1: J16.1, R2.1, Relay_Module_2R1.10 (NC_1)
/Encoder_2: J18.1, R1.1, Relay_Module_2R1.7 (NC_2)
/GAS: J15.2, R3.1, Relay_Module_2R1.2 (IN1), Relay_Module_2R1.3 (IN2)
/PA0: J4.34 (PA0/WK_UP)
/PA1: J4.33 (PA1)
/PA6: J4.28 (PA6)
/PA7: J4.27 (PA7)
/PA8: J2.3, J5.19 (PA8)
/PA9: J2.14, J5.22 (PA9/TXD1)
/PA10: J2.4, J5.21 (PA10/RXD1)
/PA11: J2.15, J5.24 (PA11/USB_DM), J20.2
/PA12: J2.1, J5.23 (PA12/USB_DP), J20.1
/PA15: J2.16, J5.26 (PA15/TDI)
/PB0: J4.24 (PB0)
/PB1: J4.23 (PB1)
/PB3: J1.5, J5.38 (PB3/TDO)
/PB5: J1.8, J5.37 (PB5)
/PB8: J1.3, J5.42 (PB8)
/PB9: J1.6, J5.41 (PB9)
/PB10: J4.13 (PB10)
/PB11: J4.12 (PB11)
/PB12: J4.11 (PB12), J14.4 (CRX)
/PB13: J4.10 (PB13), J14.3 (CTX)
/PB14: J1.2, J4.9 (PB14)
/PB15: J2.9, J5.8 (PB15)
/PC0: J4.38 (PC0)
/PC1: J4.37 (PC1)
/PC2: J4.36 (PC2)
/PC3: J4.35 (PC3)
/PC4: J4.26 (PC4)
/PC5: J4.25 (PC5)
/PC6: J5.15 (PC6), PWM_to_V2.3 (PWM)
/PC7: J5.18 (PC7), PWM_to_V1.3 (PWM)
/PC8: J2.6, J5.17 (PC8)
/PC9: J2.13, J5.20 (PC9)
/PC10: J2.2, J5.25 (PC10)
/PC11: J1.14, J5.28 (PC11)
/PC12: J1.13, J5.27 (PC12)
/PC13: J4.39 (PC13)
/PD0: J5.30 (PD0), J13.4 (CRX)
/PD1: J5.29 (PD1), J13.3 (CTX)
/PD2: J1.11, J5.32 (PD2)
/PD3: J1.12, J5.31 (PD3)
/PD4: J1.9, J5.34 (PD4)
/PD5: J5.33 (PD5), R10.1
/PD6: J1.7, J5.36 (PD6)
/PD7: J1.10, J5.35 (PD7)
/PD8: J2.7, J5.7 (PD8)
/PD9: J2.10, J5.10 (PD9)
/PD10: J5.9 (PD10), J9.1
/PD11: J5.12 (PD11), R15.1
/PD12: J2.8, J5.11 (PD12)
/PD13: J2.11, J5.14 (PD13)
/PD14: J2.5, J5.13 (PD14)
/PD15: J2.12, J5.16 (PD15)
/PE0: J1.1, J5.44 (PE0)
/PE1: J1.4, J5.43 (PE1)
/PE2: J4.44 (PE2)
/PE3: J4.43 (PE3)
/PE4: J4.42 (PE4)
/PE5: J4.41 (PE5)
/PE6: J4.40 (PE6)
/PE7: J4.22 (PE7)
/PE8: J4.21 (PE8)
/PE9: J4.20 (PE9)
/PE11: J4.18 (PE11)
/PE12: J4.17 (PE12)
/PE13: J4.16 (PE13)
/PE14: J4.15 (PE14)
/PE15: J4.14 (PE15)
/SCL: J5.40 (PB6), J7.2, R13.1
/SDA: J5.39 (PB7), J8.1, R14.2
/Switch_Robot-Person: J15.1, Relay_Module_1R2_DistSafe1.4 (COM)
GND: 5V-30V_Converter1.2 (-Vin), 5V-30V_Converter1.3 (-Vout), C1.1, C2.1, C3.1, J3.2, J3.4, J3.6, J3.8, J3.10, J4.3 (GND), J4.4 (GND), J4.5 (GND), J4.6 (GND), J5.5 (GND), J5.6 (GND), J6.2, J6.4, J6.6, J6.8, J6.10, J8.2, J10.2, J13.2 (GND), J14.2 (GND), J19.2, J20.3, PWM_to_V1.2 (GND), PWM_to_V1.4 (GND), PWM_to_V1.6 (GND), PWM_to_V2.2 (GND), PWM_to_V2.4 (GND), PWM_to_V2.6 (GND), Q1.3 (E), R4.2, R5.1, R6.1, R7.2, R11.1, Relay_Module_1R1.2 (GND), Relay_Module_1R2_DistSafe1.1 (GND), Relay_Module_1R2_DistSafe1.5 (NC), Relay_Module_2R1.1 (GND)
unnamed: 5V-30V_Converter1.4 (+Vout), F1.2
unnamed: D1.2 (A), J10.1
unnamed: D2.1 (K), Relay_Module_1R2_DistSafe1.2 (VCC)
unnamed: D3.1 (K), J20.4
unnamed: J4.32 (PA2/USART_TX), R7.1, R9.1
unnamed: C2.2, J4.31 (PA3/USART_RX), R2.2, RV2.1
unnamed: J4.30 (PA4), R6.2, R8.1
unnamed: C1.2, J4.29 (PA5), R1.2, RV1.1
unnamed: C3.2, J4.19 (PE10), R3.2
unnamed: J9.2, R15.2
unnamed: J12.1, J13.5 (CAN_H)
unnamed: J12.2, J13.6 (CAN_L)
unnamed: J11.1, J14.5 (CAN_H)
unnamed: J11.2, J14.6 (CAN_L)
unnamed: F1.1, PWM_to_V1.1 (VCC), PWM_to_V2.1 (VCC)
unnamed: Q1.1 (B), R10.2, R11.2
unnamed: Q1.2 (C), R12.2, Relay_Module_1R1.3 (IN1)
unnamed: R4.1, RV2.2, RV2.3
unnamed: R5.2, RV1.2, RV1.3
unnamed: J17.2, Relay_Module_1R1.5 (COM)
unnamed: J17.1, Relay_Module_1R1.4 (NO)
unnamed: J16.2, Relay_Module_2R1.9 (COM_1)
unnamed: J18.2, Relay_Module_2R1.6 (COM_2)

Notes on the sheet:
ООО "Беспилотный погрузчик"
Плата управления
Схема принципиальная
Лаухин

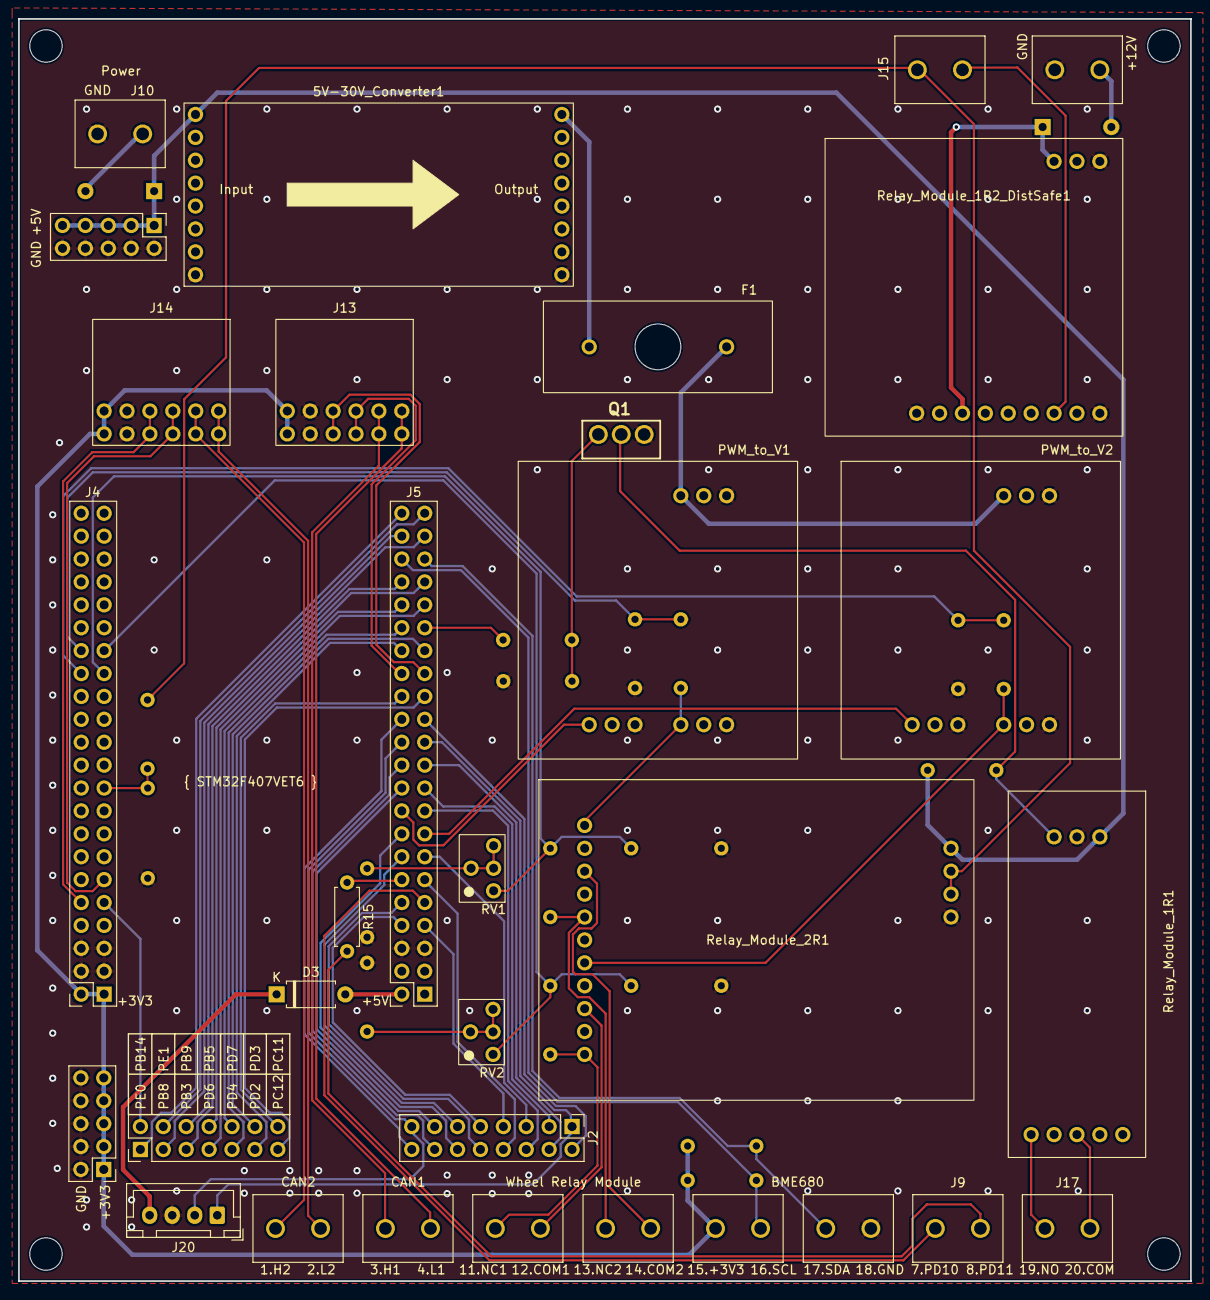
[picture p37: board Main_STM_box.kicad_pcb from above]

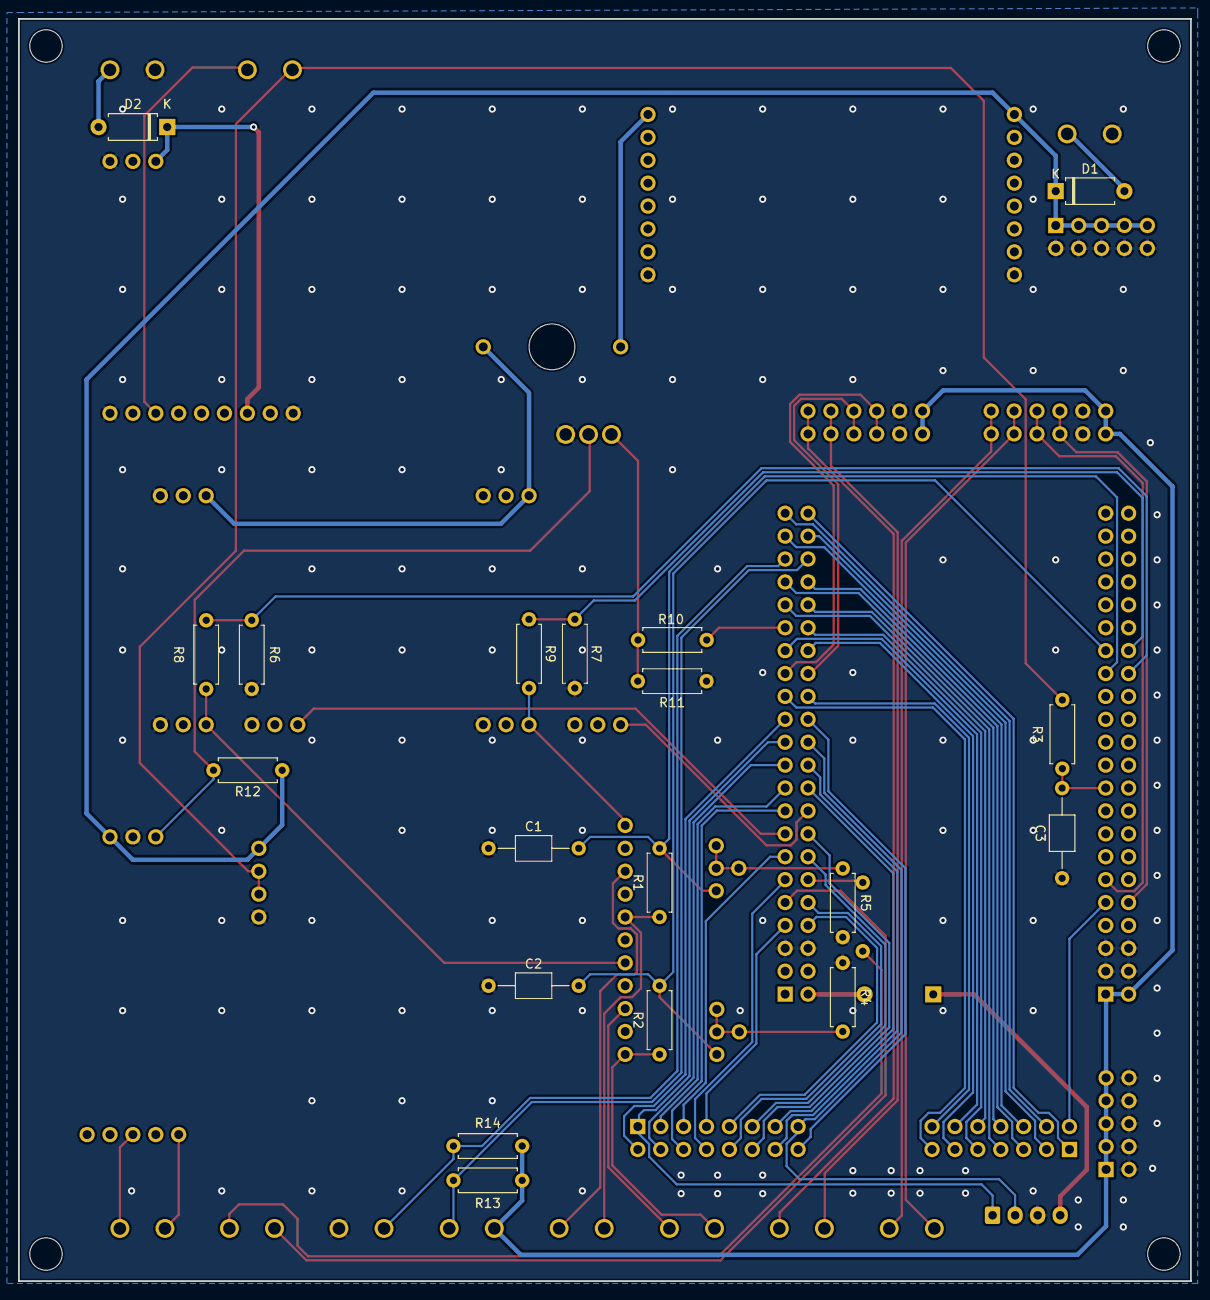
[picture p38: board Main_STM_box.kicad_pcb from below]

Board: 2 copper layers, 130.0 x 140.0 mm, 51 parts (21 on the bottom side), 75 nets.
