Kirill-Zaikin/MY_WORK_REPOSITORY/(commit log)

2025-03-12 копим на Лексус
    [Backup_of_Беспилотный погрузчик.spl8, Backup_of_Беспилотный_погрузчик_схема_соединений.spl8, Backup_of_ПАК.spl8, Backup_of_Плата для космонавтов.spl8, Backup_of_Плата управления.spl8, Беспилотный_погрузчик_схема_соединений.spl8, Винт для лампы.SLDPRT, Держало лампы.STEP]
2025-03-29 Наклейки для робота
2025-04-04 Практикум по разводке ПП
2025-04-18 Внесены исправления в схемы Э3
    [Backup_of_Backup_of_Беспилотный погрузчик.spl8, Backup_of_ПАК.spl8, Backup_of_Плата управления.spl8, ПАК.spl8, Плата управления.spl8]
2025-05-22 что-то добавил
2025-06-02 добавлена схема Э4
    [Беспилотный_погрузчик_схема_соединений.spl8]
2025-06-05 Добавлены реквизиты компании
2025-06-13 Добавлены новые госты
2025-06-15 Добавлены ГОСТы по робототехнике
2025-07-11 Добавлены чертежи жгута и ГОСТы
    [Backup_of_Беспилотный_погрузчик_схема_соединений.spl8, Backup_of_ПАК.spl8, Клипса для картона.SLDPRT, Клипса для картона.STEP, Клипсы с меткой.SLDASM, Метка с фанерой.SLDASM, Метка.SLDPRT, Плата камеры С270.SLDPRT]
2025-08-18 Слставлен альбом чертежей
    [Backup_of_Беспилотный_погрузчик_схема_соединений.spl8, Backup_of_ПАК.spl8, Backup_of_Плата управления.spl8, Backup_of_ТИТУЛЬНИК НА КД.spl8, Main_STM_box-B_Cu.dxf, Main_STM_box-Edge_Cuts.dxf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]
2025-08-27 Добавлена папка с наклейками
    [Backup_of_Беспилотный_погрузчик_схема_соединений.spl8, Backup_of_ПАК.spl8, Беспилотный_погрузчик_схема_соединений.spl8, ПАК.spl8, Плата управления.spl8]
